sudaozhen/-/SDCard/readme.txt

电梯语音报站器说明文档

【01文件夹】 里为语音，对应序号为对应层。

【02文件夹】 里为背景音乐，按编号顺序播放，不编号不分先后。

【重要说明】：先写入02文件夹背景音乐，再写入01文件夹语音。

2015年4月6日 技术支持 苏道桢
