sudaozhen/-/(list of files, drawings)

Other design files:
sch/voice.PrjPCB
sch/voice.SchDoc
sch/voice/Documents/Documents.PrjPcb
sch/voice/Documents/VOICE.SchDoc
sch/voice/Documents/voice.SCHLIB
